adafruit/Adafruit_Crickit_PCBs/(threads)

Thread 1 (2019-11-12):

Increase 3.3v output capacity of Crickit FeatherWing

CedarGroveStudios, 2019-11-12:
If possible, suggest upgrading the 3.3V regulator on future versions to increase output capacity from 150mA to 600mA to accommodate Feather boards with NeoPixels such as the PyBadge and PyGamer. Another option would be to provide +5v to the FeatherWing USB pin to allow the attached boards to derive their own 3.3V power.
