adafruit/Adafruit_Crickit_PCBs/Adafruit Crickit FeatherWing.sch

## EAGLE design Adafruit Crickit FeatherWing.sch (2018-06-22)

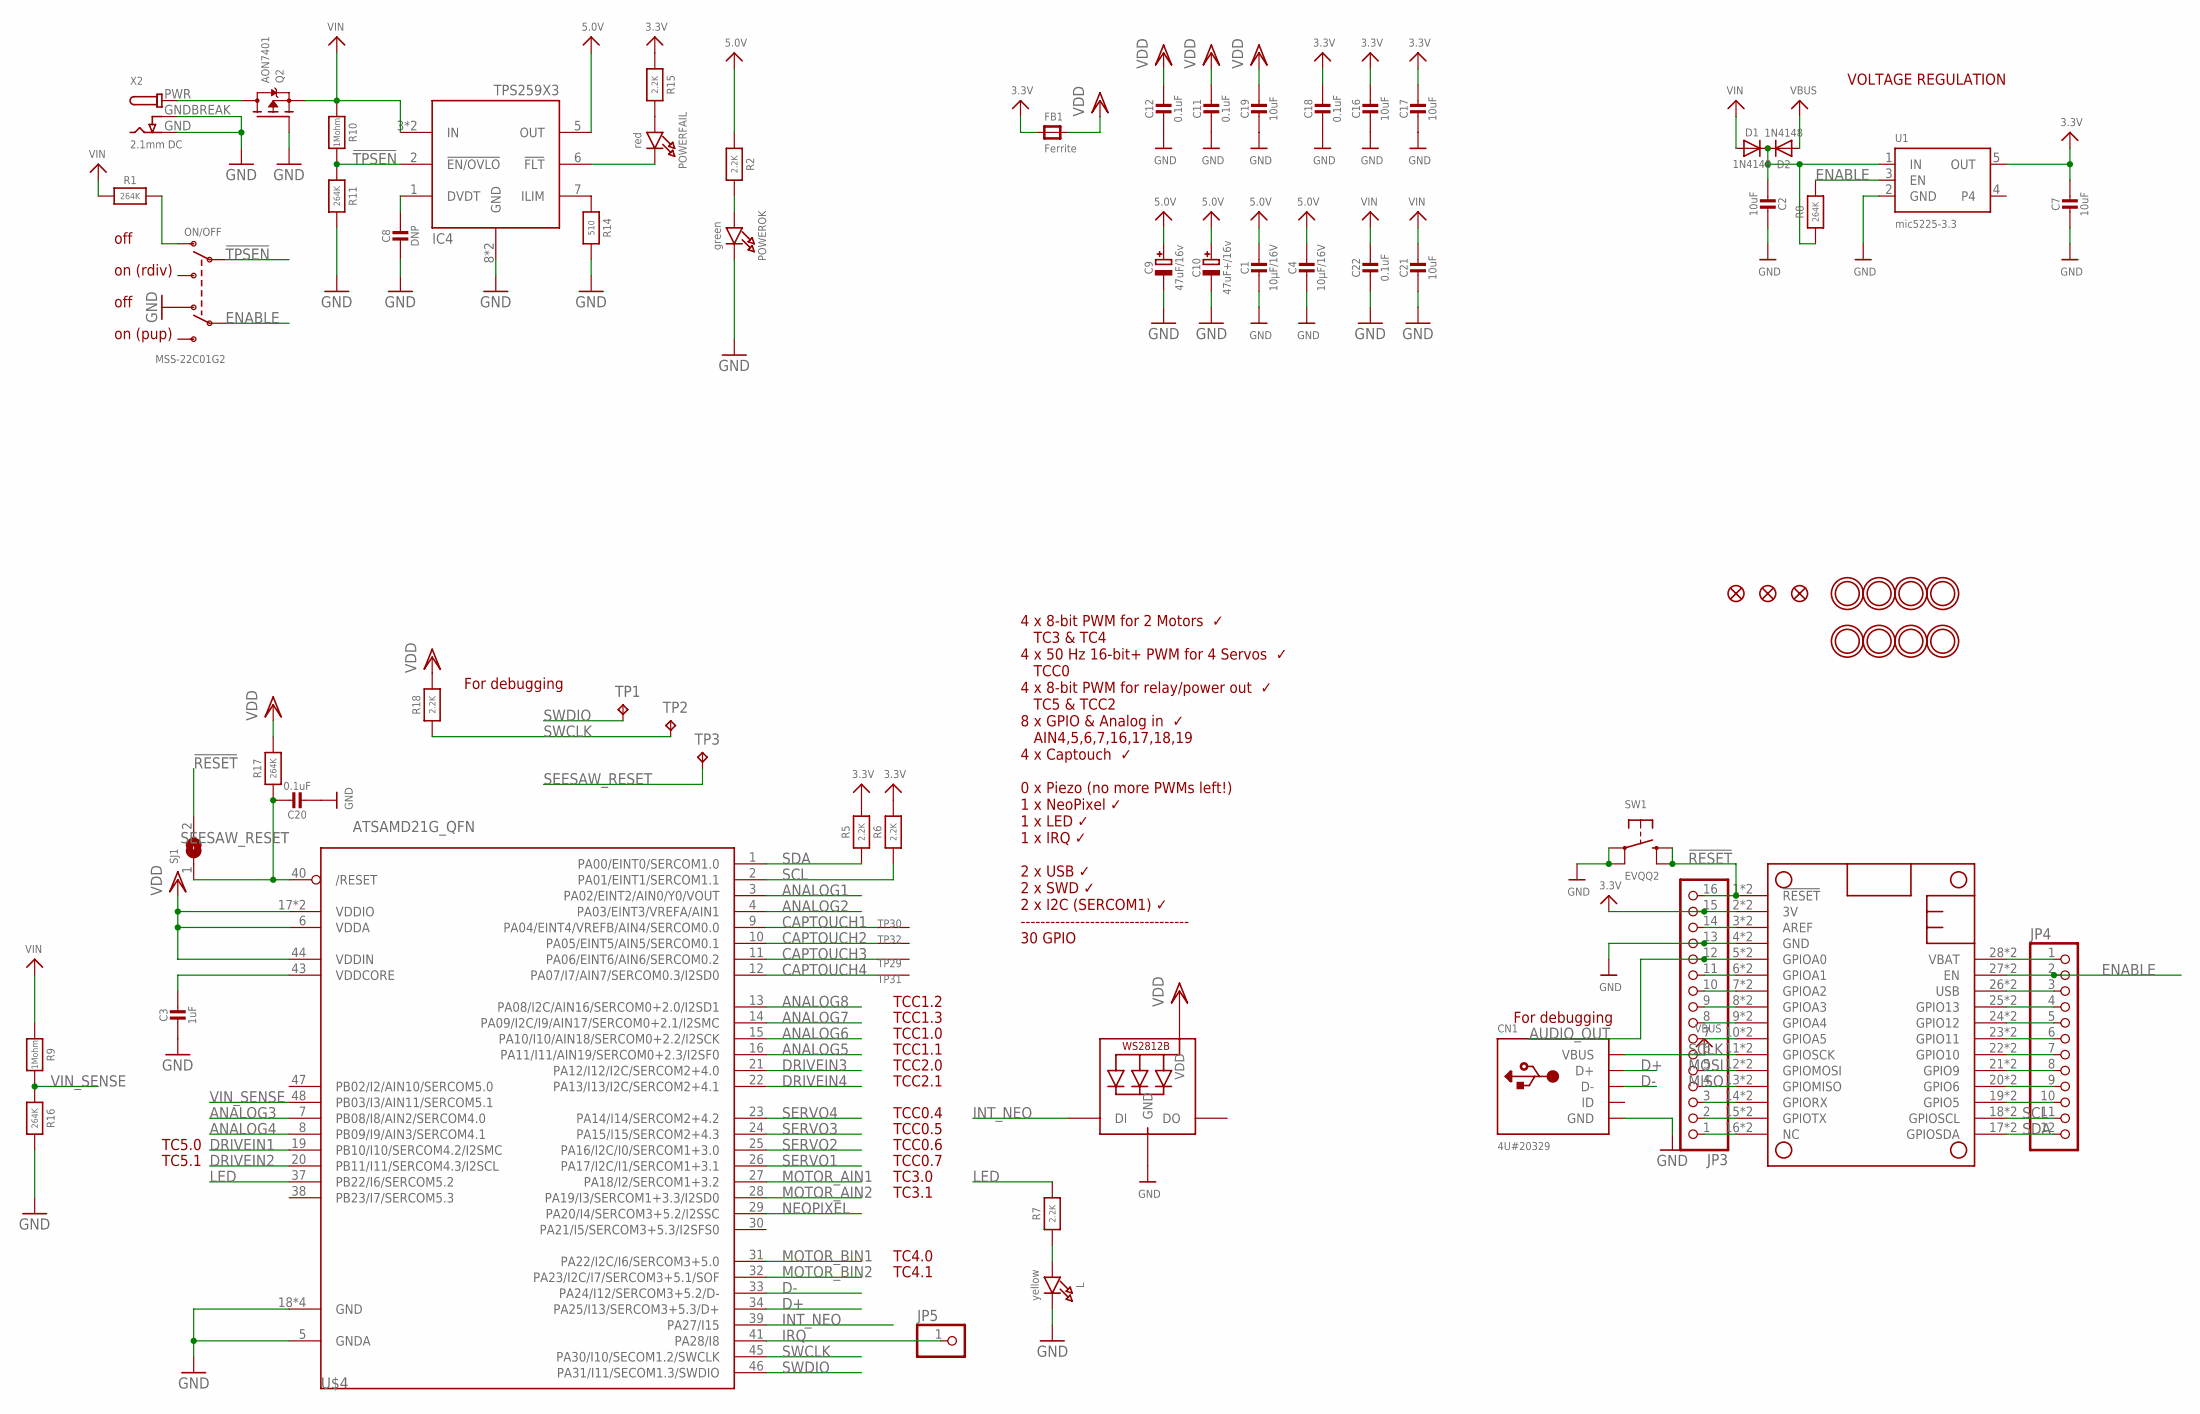
[picture p1: schematic Adafruit Crickit FeatherWing.sch, sheet 1]

Parts:
C1, C4: 10µF/16V; 0805-NO
C2, C7, C16, C17, C19, C21: 10uF; 0805-NO
C3: 1uF; 0805_10MGAP
C8: DNP; 0603-NO
C9: 47uF/16v; PANASONIC_C
C10: 47uF+/16v; PANASONIC_C
C11, C12, C18, C20, C22: 0.1uF; 0805-NO
CN1: 4U#20329; 4UCONN_20329_V2
D1, D2: 1N4148; SOD-323
FB1: Ferrite; 0805-NO
FID1, FID2, FID3: FIDUCIAL_1MM
IC4: TPS259573; WSON8
JP3: HEADER-1X16ROUND; 1X16_ROUND
JP4: HEADER-1X12; 1X12_ROUND
JP5: HEADER-1X1ROUND; 1X01_ROUND
L: yellow; CHIPLED_0805_NOOUTLINE
LED1: WS2812B3535; LED3535
MS2: FEATHERWING_SMTDUAL; FEATHERWING_SMT2
ON/OFF: MSS-22C01G2; EG1390
POWERFAIL: red; CHIPLED_0805_NOOUTLINE
POWEROK: green; CHIPLED_0805_NOOUTLINE
Q2: AON7401; POWERDI3333
R1, R8, R11, R16, R17: 264K; 0603-NO
R2, R5, R6, R7, R15, R18: 2.2K; 0603-NO
R9, R10: 1Mohm; 0603-NO
R14: 510; 0603-NO
SJ1: SOLDERJUMPERCLOSED; SOLDERJUMPER_CLOSEDWIRE
SW1: EVQQ2; EVQ-Q2_SMALLER
TP1, TP2, TP3: TPTP15R; TP15R
TP29, TP30, TP31, TP32: SEWTAPPCB_ALLIGATOR; PCB_ALLI
U1: mic5225-3.3; SOT23-5
U$4: ATSAMD21G_QFN; TQFN48_7MM
U$41, U$42, U$43, U$44, U$49, U$50, U$51, U$52: MOUNTINGHOLE3.0_NPH; MOUNTINGHOLE_3.0_NPH
X2: 2.1mm DC; DCJACK_2MM_PTH

Connections:
3.3V: C7.1, C16.1, C17.1, C18.1, FB1.1, JP3.15, MS2.2 (3V), R5.2, R6.2, R15.1, U1.5 (OUT)
5.0V: C1.1, C4.1, C9.+, C10.+, IC4.5 (OUT), R2.1
!RESET: JP3.16, MS2.1 (!RESET), SJ1.2, SW1.B (S), SW1.B' (S1)
!TPSEN: IC4.2 (!EN/OVLO), ON/OFF.P1, R10.2, R11.1
ANALOG1: U$4.3 (PA02/EINT2/AIN0/Y0/VOUT)
ANALOG2: U$4.4 (PA03/EINT3/VREFA/AIN1)
ANALOG3: U$4.7 (PB08/I8/AIN2/SERCOM4.0)
ANALOG4: U$4.8 (PB09/I9/AIN3/SERCOM4.1)
ANALOG5: U$4.16 (PA11/I11/AIN19/SERCOM0+2.3/I2SF0)
ANALOG6: U$4.15 (PA10/I10/AIN18/SERCOM0+2.2/I2SCK)
ANALOG7: U$4.14 (PA09/I2C/I9/AIN17/SERCOM0+2.1/I2SMC)
ANALOG8: U$4.13 (PA08/I2C/AIN16/SERCOM0+2.0/I2SD1)
AREF: JP3.14, MS2.3 (AREF)
AUDIO_OUT: JP3.12, MS2.5 (GPIOA0)
B: JP3.11, MS2.6 (GPIOA1)
C: JP3.10, MS2.7 (GPIOA2)
CAPTOUCH1: TP30.P$1, U$4.9 (PA04/EINT4/VREFB/AIN4/SERCOM0.0)
CAPTOUCH2: TP32.P$1, U$4.10 (PA05/EINT5/AIN5/SERCOM0.1)
CAPTOUCH3: TP29.P$1, U$4.11 (PA06/EINT6/AIN6/SERCOM0.2)
CAPTOUCH4: TP31.P$1, U$4.12 (PA07/I7/AIN7/SERCOM0.3/I2SD0)
D: JP3.9, MS2.8 (GPIOA3)
D+: CN1.D+, U$4.34 (PA25/I13/SERCOM3+5.3/D+)
D-: CN1.D-, U$4.33 (PA24/I12/SERCOM3+5.2/D-)
DRIVEIN1: U$4.19 (PB10/I10/SERCOM4.2/I2SMC)
DRIVEIN2: U$4.20 (PB11/I11/SERCOM4.3/I2SCL)
DRIVEIN3: U$4.21 (PA12/I12/I2C/SERCOM2+4.0)
DRIVEIN4: U$4.22 (PA13/I13/I2C/SERCOM2+4.1)
E: JP3.8, MS2.9 (GPIOA4)
ENABLE: JP4.2, MS2.27 (EN), ON/OFF.P2, R8.2, U1.3 (EN)
F: JP3.7, MS2.10 (GPIOA5)
G: JP3.1, MS2.16 (NC)
GND: C1.2, C2.1, C3.2, C4.2, C7.2, C8.2, C9.-, C10.-, C11.2, C12.2, C16.2, C17.2, C18.2, C19.2, C20.2, C21.2, C22.2, CN1.BASE@1 (GND), IC4.8 (GND), JP3.13, L.C, LED1.4 (GND), MS2.4 (GND), ON/OFF.O2, POWEROK.C, Q2.4 (G), R11.2, R14.2, R16.2, SW1.A, SW1.A' (P1), U1.2 (GND), U$4.5 (GNDA), U$4.18 (GND), X2.GND, X2.GNDBREAK
INT_NEO: LED1.1 (DI), U$4.39 (PA27/I15)
IRQ: JP5.1, U$4.41 (PA28/I8)
L: JP4.6, MS2.23 (GPIO11)
LED: R7.2, U$4.37 (PB22/I6/SERCOM5.2)
M: JP4.5, MS2.24 (GPIO12)
MISO: JP3.4, MS2.13 (GPIOMISO)
MOSI: JP3.5, MS2.12 (GPIOMOSI)
MOTOR_AIN1: U$4.27 (PA18/I2/SERCOM1+3.2)
MOTOR_AIN2: U$4.28 (PA19/I3/SERCOM1+3.3/I2SD0)
MOTOR_BIN1: U$4.31 (PA22/I2C/I6/SERCOM3+5.0)
MOTOR_BIN2: U$4.32 (PA23/I2C/I7/SERCOM3+5.1/SOF)
N: JP4.4, MS2.25 (GPIO13)
unnamed: C2.2, D1.C, D2.C, R8.1, U1.1 (IN)
unnamed: ON/OFF.O1, R1.2
unnamed: L.A, R7.1
unnamed: JP4.7, MS2.22 (GPIO10)
unnamed: JP4.8, MS2.21 (GPIO9)
unnamed: IC4.7 (ILIM), R14.1
unnamed: JP4.9, MS2.20 (GPIO6)
unnamed: JP4.10, MS2.19 (GPIO5)
unnamed: POWERFAIL.A, R15.2
unnamed: IC4.6 (!FLT), POWERFAIL.C
unnamed: C8.1, IC4.1 (DVDT)
unnamed: POWEROK.A, R2.2
NEOPIXEL: U$4.29 (PA20/I4/SERCOM3+5.2/I2SSC)
PWR: Q2.5678 (D), X2.PWR
RX: JP3.3, MS2.14 (GPIORX)
SCL: JP4.11, MS2.18 (GPIOSCL), R6.1, U$4.2 (PA01/EINT1/SERCOM1.1)
SCLK: JP3.6, MS2.11 (GPIOSCK)
SDA: JP4.12, MS2.17 (GPIOSDA), R5.1, U$4.1 (PA00/EINT0/SERCOM1.0)
SEESAW_RESET: C20.1, R17.1, SJ1.1, TP3.TP, U$4.40 (/RESET)
SERVO1: U$4.26 (PA17/I2C/I1/SERCOM1+3.1)
SERVO2: U$4.25 (PA16/I2C/I0/SERCOM1+3.0)
SERVO3: U$4.24 (PA15/I15/SERCOM2+4.3)
SERVO4: U$4.23 (PA14/I14/SERCOM2+4.2)
SWCLK: R18.1, TP2.TP, U$4.45 (PA30/I10/SECOM1.2/SWCLK)
SWDIO: TP1.TP, U$4.46 (PA31/I11/SECOM1.3/SWDIO)
TX: JP3.2, MS2.15 (GPIOTX)
USB: JP4.3, MS2.26 (USB)
VBAT: JP4.1, MS2.28 (VBAT)
VBUS: CN1.VBUS, D2.A
VDD: C11.1, C12.1, C19.1, FB1.2, LED1.2 (VDD), R17.2, R18.2, U$4.6 (VDDA), U$4.17 (VDDIO), U$4.44 (VDDIN)
VDDCORE: C3.1, U$4.43 (VDDCORE)
VIN: C21.1, C22.1, D1.A, IC4.3 (IN), Q2.1 (S), R1.1, R9.1, R10.1
VIN_SENSE: R9.2, R16.1, U$4.48 (PB03/I3/AIN11/SERCOM5.1)

Notes on the sheet:
TCC2.1
TCC2.0
TCC1.2
TCC1.3
TCC1.1
TCC1.0
TCC0.4
TCC0.5
TCC0.6
TCC0.7
TC3.0
TC3.1
TC4.0
TC4.1
4 x 8-bit PWM for 2 Motors ✓ TC3 & TC4 4 x 50 Hz 16-bit+ PWM for 4 Servos ✓ TCC0 4 x 8-bit PWM for relay/power out ✓ TC5 & TCC2 8 x GPIO & Analog in ✓ AIN4,5,6,7,16,17,18,19 4 x Captouch ✓ 0 x Piezo (no more PWMs left!) 1 x NeoPixel ✓ 1 x LED ✓ 1 x IRQ ✓ 2 x USB ✓ 2 x SWD ✓ 2 x I2C (SERCOM1) ✓ ----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
TC5.0
TC5.1
For debugging
VOLTAGE REGULATION
off
on (rdiv)
on (pup)

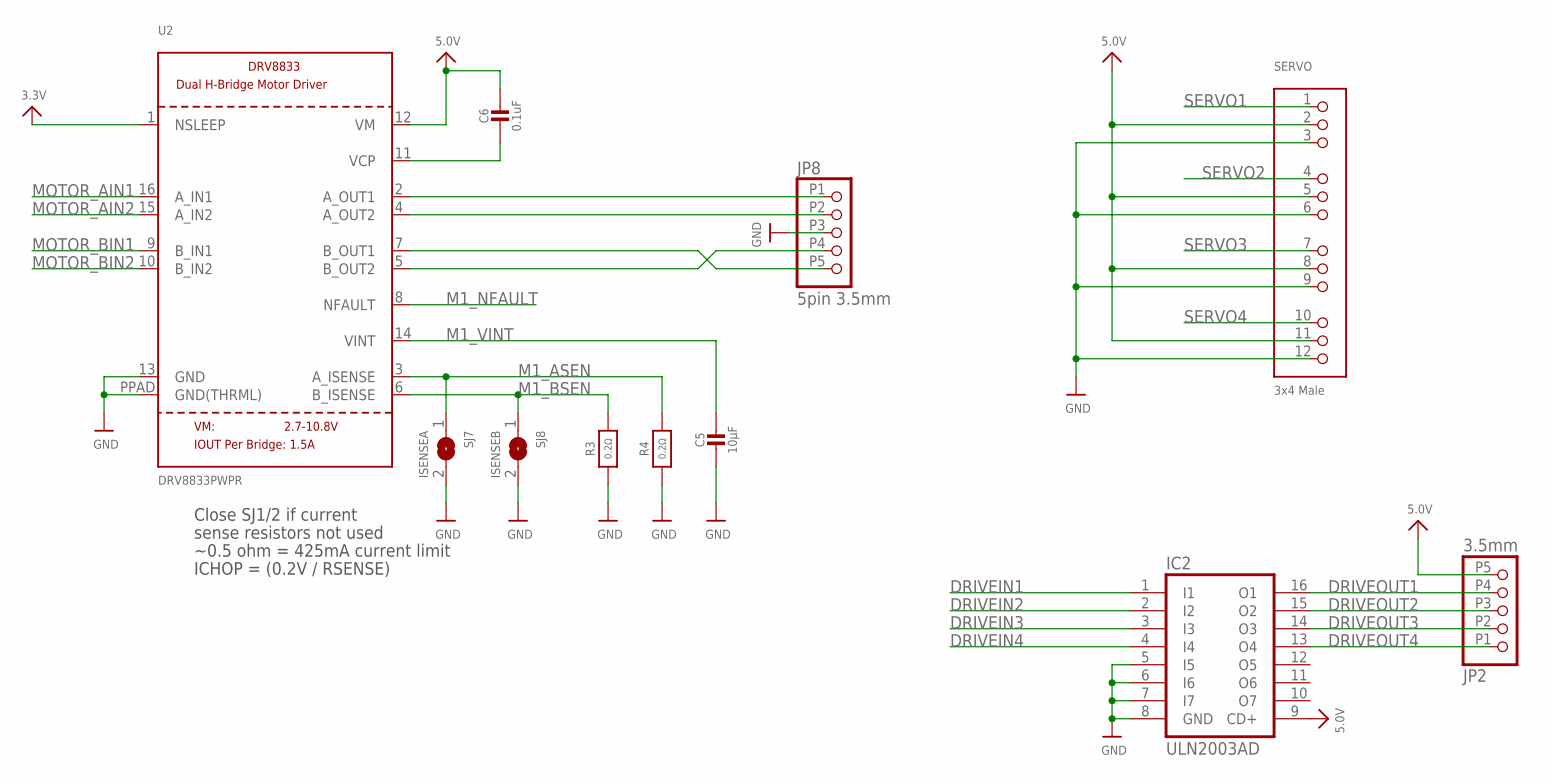
[picture p2: schematic Adafruit Crickit FeatherWing.sch, sheet 2]

Parts:
C5: 10µF; 0805-NO
C6: 0.1uF; 0805-NO
IC2: ULN2003AD; SO16
JP2: 3.5mm; TERMBLOC_1X5-3.5MM
JP8: 5pin 3.5mm; TERMBLOC_1X5-3.5MM
R3, R4: 0.2Ω; _1206
SERVO: 3x4 Male; 3X04
SJ7: ISENSEA; SOLDERJUMPER_ARROW_NOPASTE
SJ8: ISENSEB; SOLDERJUMPER_ARROW_NOPASTE
U2: DRV8833PWPR; HTSSOP16

Connections:
3.3V: U2.1 (NSLEEP)
5.0V: C6.1, IC2.9 (CD+), JP2.P5 (5), SERVO.2, SERVO.5, SERVO.8, SERVO.11, U2.12 (VM)
AOUT3: JP8.P1 (1), U2.2 (A_OUT1)
AOUT4: JP8.P2 (2), U2.4 (A_OUT2)
DRIVEIN1: IC2.1 (I1)
DRIVEIN2: IC2.2 (I2)
DRIVEIN3: IC2.3 (I3)
DRIVEIN4: IC2.4 (I4)
DRIVEOUT1: IC2.16 (O1), JP2.P4 (4)
DRIVEOUT2: IC2.15 (O2), JP2.P3 (3)
DRIVEOUT3: IC2.14 (O3), JP2.P2 (2)
DRIVEOUT4: IC2.13 (O4), JP2.P1 (1)
GND: C5.2, IC2.5 (I5), IC2.6 (I6), IC2.7 (I7), IC2.8 (GND), JP8.P3 (3), R3.1, R4.1, SERVO.3, SERVO.6, SERVO.9, SERVO.12, SJ7.2, SJ8.2, U2.13 (GND), U2.PPAD (GND(THRML))
M1_ASEN: R4.2, SJ7.1, U2.3 (A_ISENSE)
M1_BSEN: R3.2, SJ8.1, U2.6 (B_ISENSE)
M1_NFAULT: U2.8 (NFAULT)
M1_VINT: C5.1, U2.14 (VINT)
MOTOR_AIN1: U2.16 (A_IN1)
MOTOR_AIN2: U2.15 (A_IN2)
MOTOR_BIN1: U2.9 (B_IN1)
MOTOR_BIN2: U2.10 (B_IN2)
unnamed: C6.2, U2.11 (VCP)
unnamed: JP8.P5 (5), U2.7 (B_OUT1)
unnamed: JP8.P4 (4), U2.5 (B_OUT2)
SERVO1: SERVO.1
SERVO2: SERVO.4
SERVO3: SERVO.7
SERVO4: SERVO.10

Notes on the sheet:
Close SJ1/2 if current
sense resistors not used
~0.5 ohm = 425mA current limit
ICHOP = (0.2V / RSENSE)

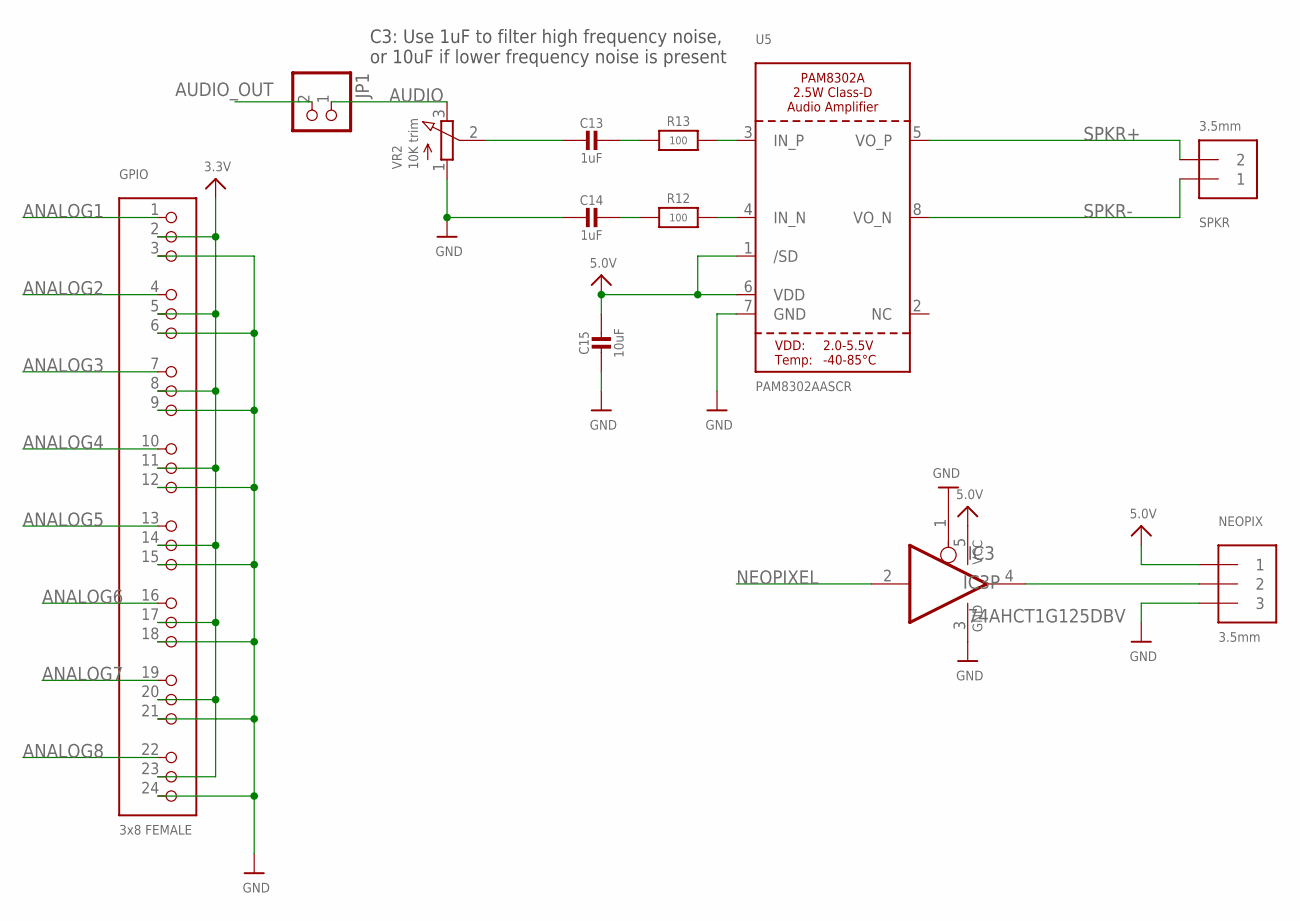
[picture p3: schematic Adafruit Crickit FeatherWing.sch, sheet 3]

Parts:
C13, C14: 1uF; 0805-NO
C15: 10uF; 0805-NO
GPIO: 3x8 FEMALE; 3X08
IC3: 74AHCT1G125DBV; SOT23-5
JP1: HEADER-1X2ROUND; 1X02_ROUND
NEOPIX: 3.5mm; TERMBLOCK_1X3-3.5MM
R12, R13: 100; 0805-NO
SPKR: 3.5mm; TERMBLOCK_1X2-3.5MM
U5: PAM8302AASCR; MSOP8_0.65MM
VR2: 10K trim; TRIMPOT_BOURNS_3303W

Connections:
3.3V: GPIO.2, GPIO.5, GPIO.8, GPIO.11, GPIO.14, GPIO.17, GPIO.20, GPIO.23
5.0V: C15.1, IC3.5 (VCC), NEOPIX.1, U5.1 (/SD), U5.6 (VDD)
ANALOG1: GPIO.1
ANALOG2: GPIO.4
ANALOG3: GPIO.7
ANALOG4: GPIO.10
ANALOG5: GPIO.13
ANALOG6: GPIO.16
ANALOG7: GPIO.19
ANALOG8: GPIO.22
AUDIO: JP1.1, VR2.3 (E)
AUDIO_OUT: JP1.2
GND: C14.2, C15.2, GPIO.3, GPIO.6, GPIO.9, GPIO.12, GPIO.15, GPIO.18, GPIO.21, GPIO.24, IC3.1 (OE), IC3.3 (GND), NEOPIX.3, U5.7 (GND), VR2.1 (A)
unnamed: IC3.4 (O), NEOPIX.2
unnamed: R12.2, U5.4 (IN_N)
unnamed: R13.2, U5.3 (IN_P)
unnamed: C14.1, R12.1
unnamed: C13.1, R13.1
unnamed: C13.2, VR2.2 (S)
NEOPIXEL: IC3.2 (I)
SPKR+: SPKR.2, U5.5 (VO_P)
SPKR-: SPKR.1, U5.8 (VO_N)

Notes on the sheet:
C3: Use 1uF to filter high frequency noise, or 10uF if lower frequency noise is present
