adafruit/Adafruit_Crickit_PCBs/Adafruit Crickit HAT.sch

## EAGLE design Adafruit Crickit HAT.sch (2018-12-14)

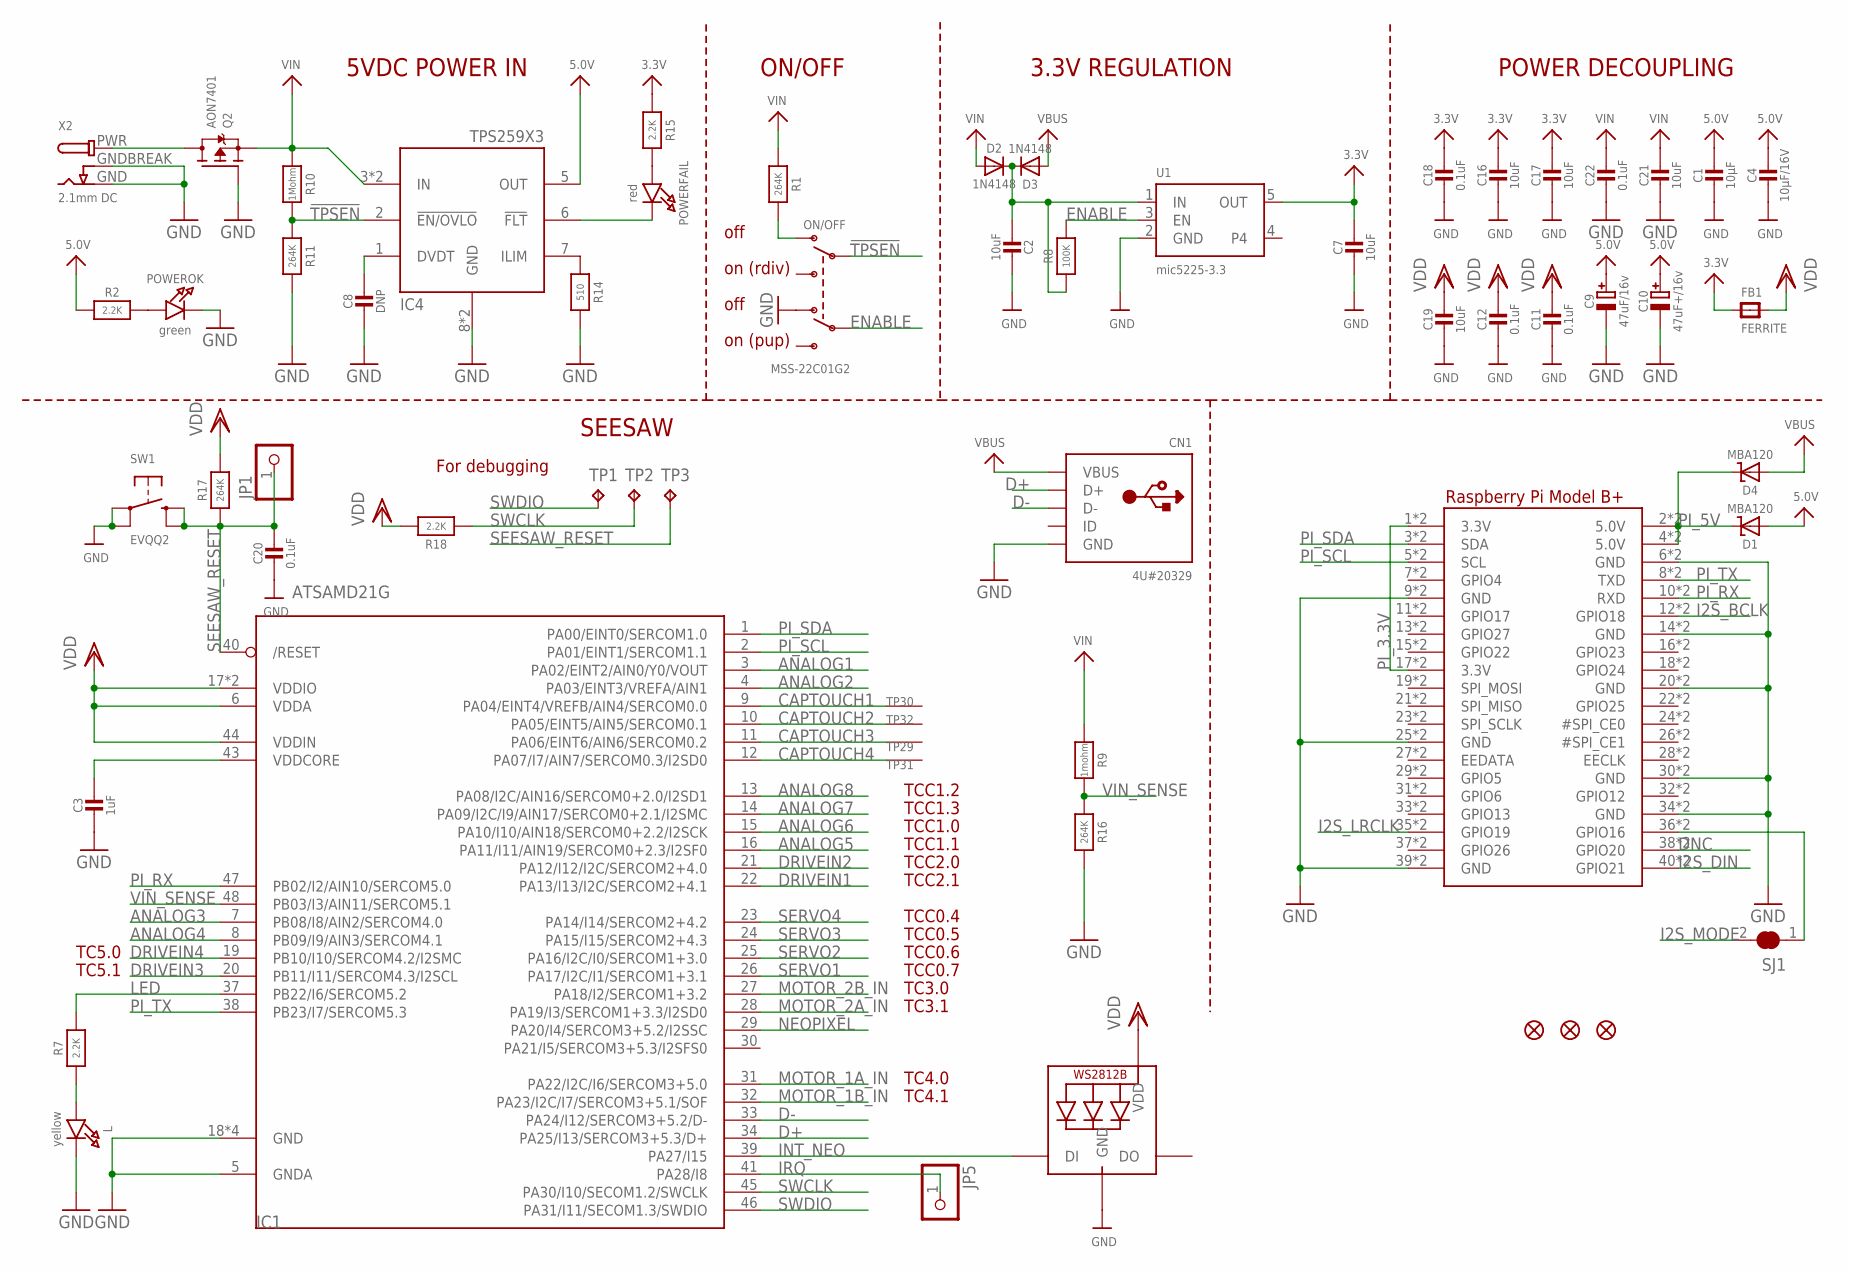
[picture p4: schematic Adafruit Crickit HAT.sch, sheet 1]

Parts:
C1: 10µF; 0805-NO
C2, C7, C16, C17, C19, C21: 10uF; 0805-NO
C3: 1uF; 0805-NO
C4: 10µF/16V; 0805-NO
C8: DNP; 0603-NO
C9: 47uF/16v; PANASONIC_C
C10: 47uF+/16v; PANASONIC_C
C11, C12, C18, C20, C22: 0.1uF; 0603-NO
CN1: 4U#20329; 4UCONN_20329_V2
D1, D4: MBA120; SOD-123
D2, D3: 1N4148; SOD-323
FB1: FERRITE; _0805MP
FID1, FID2, FID3: FIDUCIAL_1MM
IC1: ATSAMD21G; TQFN48_7MM
IC4: TPS259573; WSON8
JP1, JP5: HEADER-1X1ROUND; 1X01_ROUND
L: yellow; CHIPLED_0805_NOOUTLINE
LED1: WS2812B3535; LED3535
ON/OFF: MSS-22C01G2; EG1390
POWERFAIL: red; CHIPLED_0805_NOOUTLINE
POWEROK: green; CHIPLED_0805_NOOUTLINE
Q2: AON7401; POWERDI3333
R1, R11, R16, R17: 264K; 0603-NO
R2, R7, R15, R18: 2.2K; 0603-NO
R8: 100K; 0603-NO
R9: 1mohm; 0603-NO
R10: 1Mohm; 0603-NO
R14: 510; 0603-NO
RPI1: RASPBERRYPI_BPLUS_HAT_SMTTHM_SLOTS; PI_HAT_SMTTHM_SLOTS
SJ1: SOLDERJUMPER_CLOSED; SOLDERJUMPER_CLOSEDWIRE
SW1: EVQQ2; BTN_KMR2_4.6X2.8
TP1, TP2, TP3: TPTP15R; TP15R
TP29, TP30, TP31, TP32: SEWTAPPCB_ALLIGATOR; PCB_ALLI
U1: mic5225-3.3; SOT23-5
X2: 2.1mm DC; DCJACK_2MM_PTH

Connections:
3.3V: C7.1, C16.1, C17.1, C18.1, FB1.1, R15.1, U1.5 (OUT)
5.0V: C1.1, C4.1, C9.+, C10.+, D1.A, IC4.5 (OUT), R2.1
!TPSEN: IC4.2 (!EN/OVLO), ON/OFF.P1, R10.2, R11.1
ANALOG1: IC1.3 (PA02/EINT2/AIN0/Y0/VOUT)
ANALOG2: IC1.4 (PA03/EINT3/VREFA/AIN1)
ANALOG3: IC1.7 (PB08/I8/AIN2/SERCOM4.0)
ANALOG4: IC1.8 (PB09/I9/AIN3/SERCOM4.1)
ANALOG5: IC1.16 (PA11/I11/AIN19/SERCOM0+2.3/I2SF0)
ANALOG6: IC1.15 (PA10/I10/AIN18/SERCOM0+2.2/I2SCK)
ANALOG7: IC1.14 (PA09/I2C/I9/AIN17/SERCOM0+2.1/I2SMC)
ANALOG8: IC1.13 (PA08/I2C/AIN16/SERCOM0+2.0/I2SD1)
CAPTOUCH1: IC1.9 (PA04/EINT4/VREFB/AIN4/SERCOM0.0), TP30.P$1
CAPTOUCH2: IC1.10 (PA05/EINT5/AIN5/SERCOM0.1), TP32.P$1
CAPTOUCH3: IC1.11 (PA06/EINT6/AIN6/SERCOM0.2), TP29.P$1
CAPTOUCH4: IC1.12 (PA07/I7/AIN7/SERCOM0.3/I2SD0), TP31.P$1
D+: CN1.D+, IC1.34 (PA25/I13/SERCOM3+5.3/D+)
D-: CN1.D-, IC1.33 (PA24/I12/SERCOM3+5.2/D-)
DNC: RPI1.38 (GPIO20)
DRIVEIN1: IC1.22 (PA13/I13/I2C/SERCOM2+4.1)
DRIVEIN2: IC1.21 (PA12/I12/I2C/SERCOM2+4.0)
DRIVEIN3: IC1.20 (PB11/I11/SERCOM4.3/I2SCL)
DRIVEIN4: IC1.19 (PB10/I10/SERCOM4.2/I2SMC)
ENABLE: ON/OFF.P2, R8.2, U1.3 (EN)
GND: C1.2, C2.1, C3.2, C4.2, C7.2, C8.2, C9.-, C10.-, C11.2, C12.2, C16.2, C17.2, C18.2, C19.2, C20.2, C21.2, C22.2, CN1.BASE@1 (GND), IC1.5 (GNDA), IC1.18 (GND), IC4.8 (GND), L.C, LED1.4 (GND), ON/OFF.O2, POWEROK.C, Q2.4 (G), R11.2, R14.2, R16.2, RPI1.6 (GND), RPI1.9 (GND), RPI1.14 (GND), RPI1.20 (GND), RPI1.25 (GND), RPI1.30 (GND), RPI1.34 (GND), RPI1.39 (GND), SW1.A, SW1.A' (P1), U1.2 (GND), X2.GND, X2.GNDBREAK
I2S_BCLK: RPI1.12 (GPIO18)
I2S_DIN: RPI1.40 (GPIO21)
I2S_LRCLK: RPI1.35 (GPIO19)
I2S_MODE: SJ1.2
INT_NEO: IC1.39 (PA27/I15), LED1.1 (DI)
IRQ: IC1.41 (PA28/I8), JP5.1
LED: IC1.37 (PB22/I6/SERCOM5.2), R7.2
MOTOR_1A_IN: IC1.31 (PA22/I2C/I6/SERCOM3+5.0)
MOTOR_1B_IN: IC1.32 (PA23/I2C/I7/SERCOM3+5.1/SOF)
MOTOR_2A_IN: IC1.28 (PA19/I3/SERCOM1+3.3/I2SD0)
MOTOR_2B_IN: IC1.27 (PA18/I2/SERCOM1+3.2)
unnamed: RPI1.36 (GPIO16), SJ1.1
unnamed: ON/OFF.O1, R1.2
unnamed: L.A, R7.1
unnamed: IC4.7 (ILIM), R14.1
unnamed: POWERFAIL.A, R15.2
unnamed: IC4.6 (!FLT), POWERFAIL.C
unnamed: C8.1, IC4.1 (DVDT)
unnamed: POWEROK.A, R2.2
NEOPIXEL: IC1.29 (PA20/I4/SERCOM3+5.2/I2SSC)
PI_3.3V: RPI1.1 (3.3V), RPI1.17 (3.3V)
PI_5V: D1.C, D4.C, RPI1.2 (5.0V), RPI1.4 (5.0V)
PI_RX: IC1.47 (PB02/I2/AIN10/SERCOM5.0), RPI1.10 (RXD)
PI_SCL: IC1.2 (PA01/EINT1/SERCOM1.1), RPI1.5 (SCL)
PI_SDA: IC1.1 (PA00/EINT0/SERCOM1.0), RPI1.3 (SDA)
PI_TX: IC1.38 (PB23/I7/SERCOM5.3), RPI1.8 (TXD)
PWR: Q2.5678 (D), X2.PWR
SEESAW_RESET: C20.1, IC1.40 (/RESET), JP1.1, R17.1, SW1.B (S), SW1.B' (S1), TP3.TP
SERVO1: IC1.26 (PA17/I2C/I1/SERCOM1+3.1)
SERVO2: IC1.25 (PA16/I2C/I0/SERCOM1+3.0)
SERVO3: IC1.24 (PA15/I15/SERCOM2+4.3)
SERVO4: IC1.23 (PA14/I14/SERCOM2+4.2)
SWCLK: IC1.45 (PA30/I10/SECOM1.2/SWCLK), R18.1, TP2.TP
SWDIO: IC1.46 (PA31/I11/SECOM1.3/SWDIO), TP1.TP
VBUS: CN1.VBUS, D3.A, D4.A
VDD: C11.1, C12.1, C19.1, FB1.2, IC1.6 (VDDA), IC1.17 (VDDIO), IC1.44 (VDDIN), LED1.2 (VDD), R17.2, R18.2
VDDCORE: C3.1, IC1.43 (VDDCORE)
VHI: C2.2, D2.C, D3.C, R8.1, U1.1 (IN)
VIN: C21.1, C22.1, D2.A, IC4.3 (IN), Q2.1 (S), R1.1, R9.1, R10.1
VIN_SENSE: IC1.48 (PB03/I3/AIN11/SERCOM5.1), R9.2, R16.1

Notes on the sheet:
TCC2.1
TCC2.0
TCC1.2
TCC1.3
TCC1.1
TCC1.0
TCC0.4
TCC0.5
TCC0.6
TCC0.7
TC3.0
TC3.1
TC4.0
TC4.1
TC5.0
TC5.1
3.3V REGULATION
off
on (rdiv)
on (pup)
For debugging
ON/OFF
5VDC POWER IN
POWER DECOUPLING
SEESAW

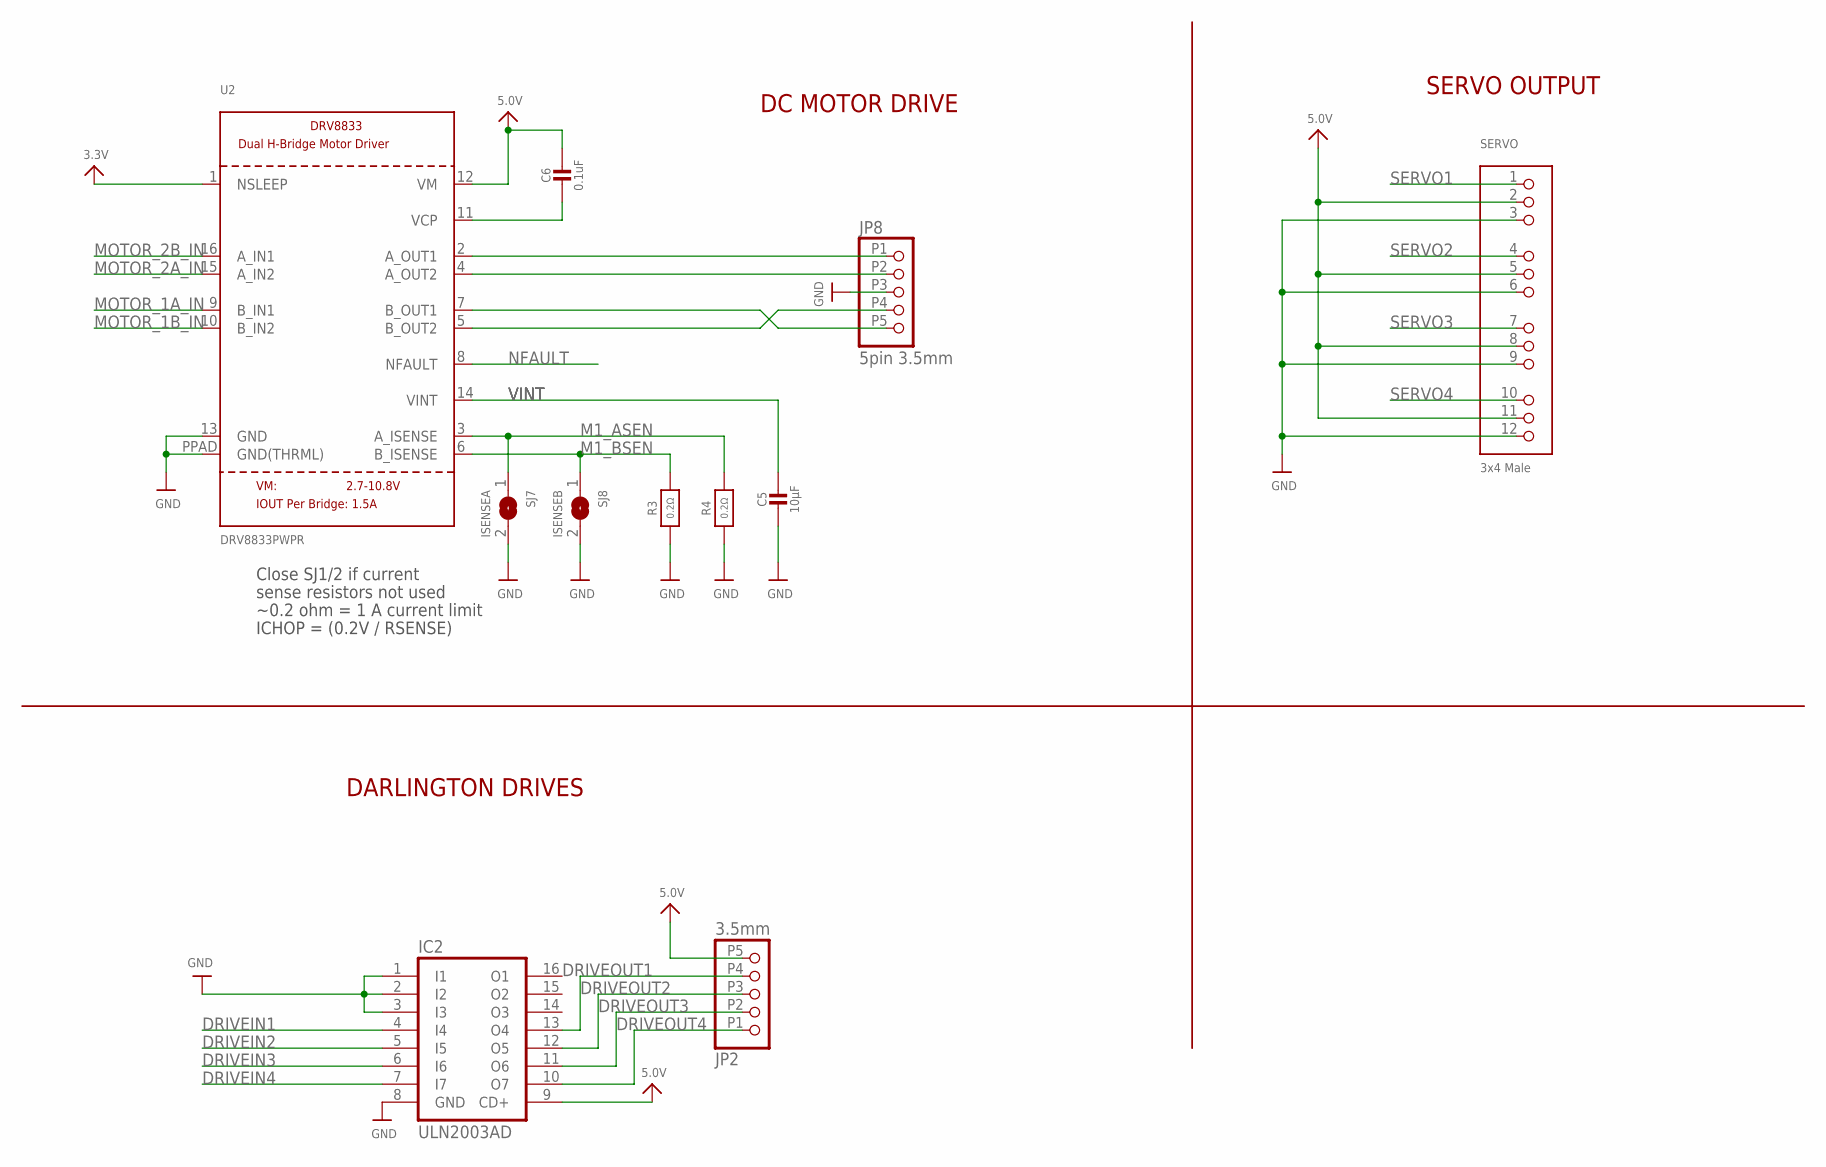
[picture p5: schematic Adafruit Crickit HAT.sch, sheet 2]

Parts:
C5: 10µF; 0805-NO
C6: 0.1uF; 0603-NO
IC2: ULN2003AD; SO16
JP2: 3.5mm; TERMBLOCK_1X5-3.5MM
JP8: 5pin 3.5mm; TERMBLOCK_1X5-3.5MM
R3, R4: 0.2Ω; _1206
SERVO: 3x4 Male; 3X04
SJ7: ISENSEA; SOLDERJUMPER_ARROW_NOPASTE
SJ8: ISENSEB; SOLDERJUMPER_ARROW_NOPASTE
U2: DRV8833PWPR; HTSSOP16

Connections:
3.3V: U2.1 (NSLEEP)
5.0V: C6.1, IC2.9 (CD+), JP2.P5 (5), SERVO.2, SERVO.5, SERVO.8, SERVO.11, U2.12 (VM)
DRIVEIN1: IC2.4 (I4)
DRIVEIN2: IC2.5 (I5)
DRIVEIN3: IC2.6 (I6)
DRIVEIN4: IC2.7 (I7)
DRIVEOUT1: IC2.13 (O4), JP2.P4 (4)
DRIVEOUT2: IC2.12 (O5), JP2.P3 (3)
DRIVEOUT3: IC2.11 (O6), JP2.P2 (2)
DRIVEOUT4: IC2.10 (O7), JP2.P1 (1)
GND: C5.2, IC2.1 (I1), IC2.2 (I2), IC2.3 (I3), IC2.8 (GND), JP8.P3 (3), R3.1, R4.1, SERVO.3, SERVO.6, SERVO.9, SERVO.12, SJ7.2, SJ8.2, U2.13 (GND), U2.PPAD (GND(THRML))
M1_ASEN: R4.2, SJ7.1, U2.3 (A_ISENSE)
M1_BSEN: R3.2, SJ8.1, U2.6 (B_ISENSE)
MOTOR_1A_IN: U2.9 (B_IN1)
MOTOR_1A_OUT: JP8.P5 (5), U2.7 (B_OUT1)
MOTOR_1B_IN: U2.10 (B_IN2)
MOTOR_1B_OUT: JP8.P4 (4), U2.5 (B_OUT2)
MOTOR_2A_IN: U2.15 (A_IN2)
MOTOR_2A_OUT: JP8.P2 (2), U2.4 (A_OUT2)
MOTOR_2B_IN: U2.16 (A_IN1)
MOTOR_2B_OUT: JP8.P1 (1), U2.2 (A_OUT1)
unnamed: C6.2, U2.11 (VCP)
NFAULT: U2.8 (NFAULT)
SERVO1: SERVO.1
SERVO2: SERVO.4
SERVO3: SERVO.7
SERVO4: SERVO.10
VINT: C5.1, U2.14 (VINT)

Notes on the sheet:
Close SJ1/2 if current
sense resistors not used
~0.2 ohm = 1 A current limit
ICHOP = (0.2V / RSENSE)
DC MOTOR DRIVE
SERVO OUTPUT
DARLINGTON DRIVES

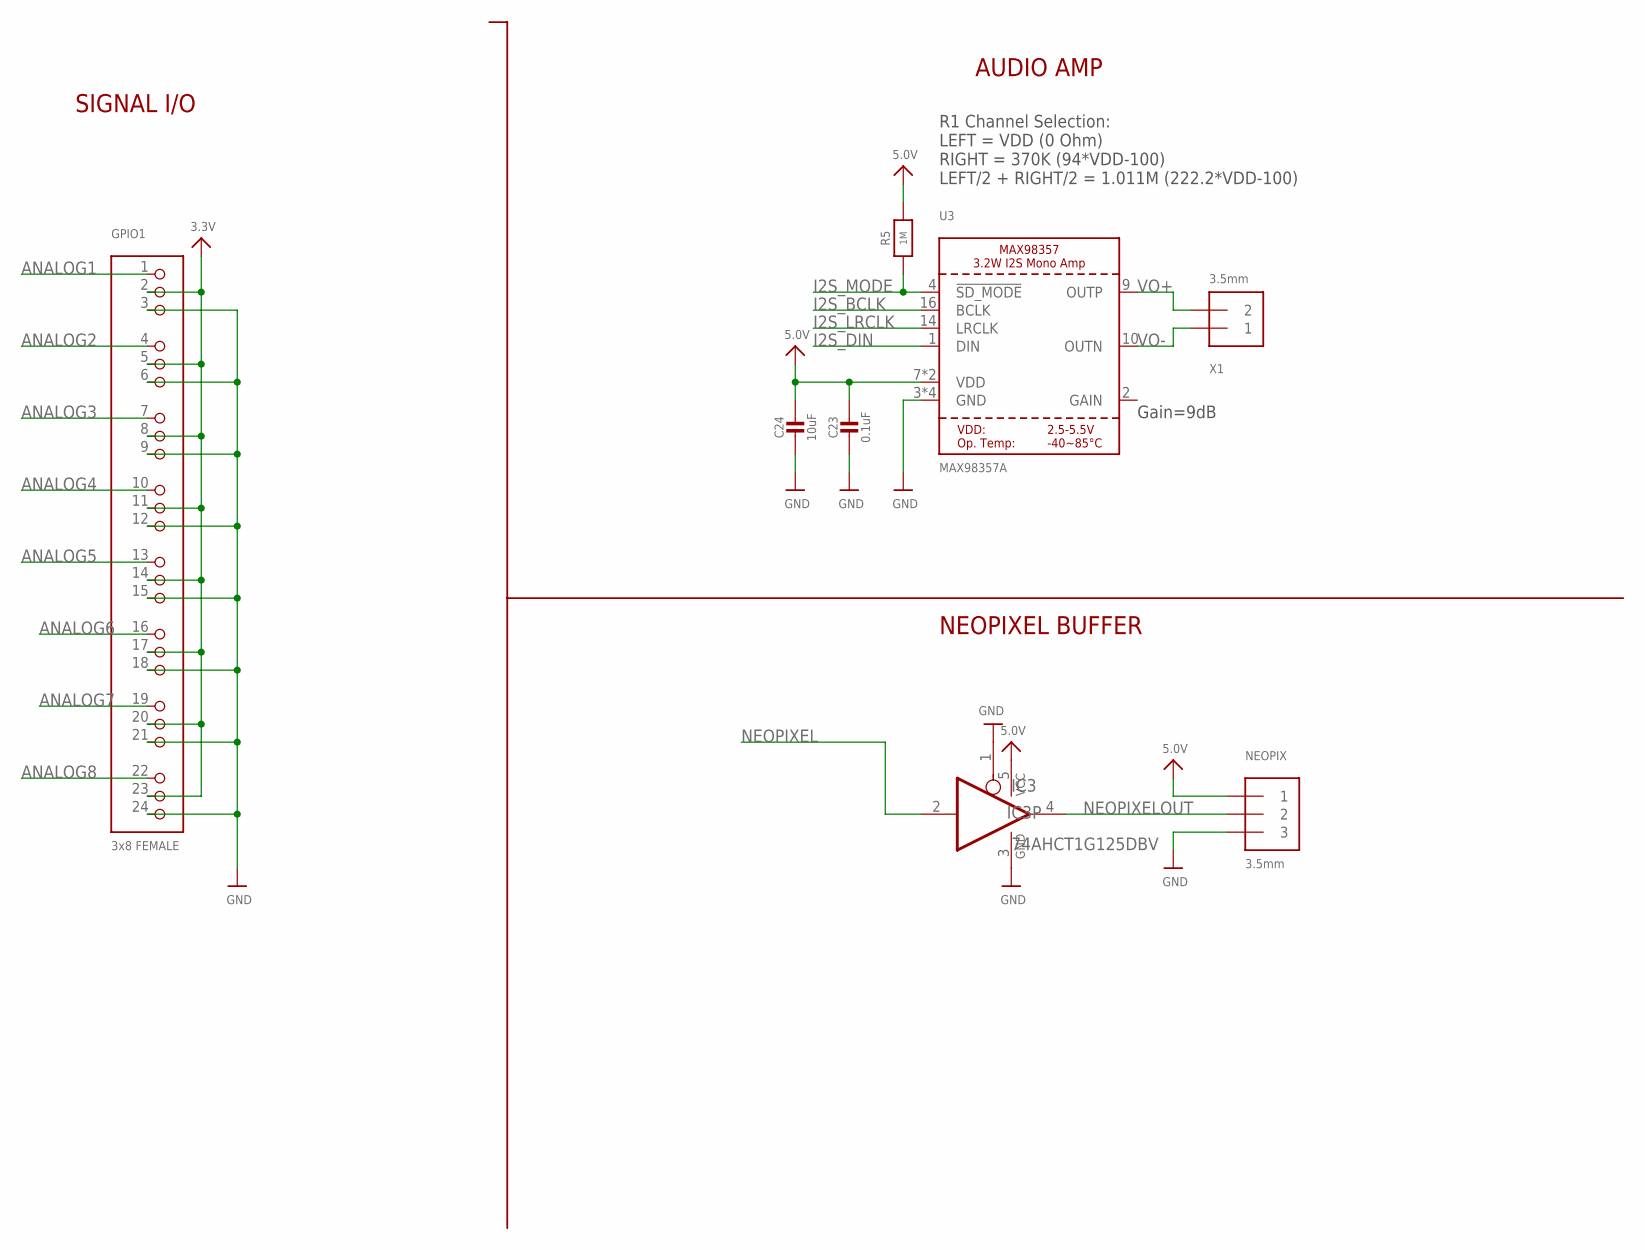
[picture p6: schematic Adafruit Crickit HAT.sch, sheet 3]

Parts:
C23: 0.1uF; 0603-NO
C24: 10uF; 0805-NO
GPIO1: 3x8 FEMALE; 3X08
IC3: 74AHCT1G125DBV; SOT23-5
NEOPIX: 3.5mm; TERMBLOCK_1X3-3.5MM
R5: 1M; 0603-NO
U3: MAX98357A; QFN16_3MM
X1: 3.5mm; TERMBLOCK_1X2-3.5MM

Connections:
3.3V: GPIO1.2, GPIO1.5, GPIO1.8, GPIO1.11, GPIO1.14, GPIO1.17, GPIO1.20, GPIO1.23
5.0V: C23.1, C24.1, IC3.5 (VCC), NEOPIX.1, R5.2, U3.7 (VDD)
ANALOG1: GPIO1.1
ANALOG2: GPIO1.4
ANALOG3: GPIO1.7
ANALOG4: GPIO1.10
ANALOG5: GPIO1.13
ANALOG6: GPIO1.16
ANALOG7: GPIO1.19
ANALOG8: GPIO1.22
GND: C23.2, C24.2, GPIO1.3, GPIO1.6, GPIO1.9, GPIO1.12, GPIO1.15, GPIO1.18, GPIO1.21, GPIO1.24, IC3.1 (OE), IC3.3 (GND), NEOPIX.3, U3.3 (GND)
I2S_BCLK: U3.16 (BCLK)
I2S_DIN: U3.1 (DIN)
I2S_LRCLK: U3.14 (LRCLK)
I2S_MODE: R5.1, U3.4 (!SD_MODE)
NEOPIXEL: IC3.2 (I)
NEOPIXELOUT: IC3.4 (O), NEOPIX.2
VO+: U3.9 (OUTP), X1.2
VO-: U3.10 (OUTN), X1.1

Notes on the sheet:
SIGNAL I/O
AUDIO AMP
NEOPIXEL BUFFER
R1 Channel Selection: LEFT = VDD (0 Ohm) RIGHT = 370K (94*VDD-100) LEFT/2 + RIGHT/2 = 1.011M (222.2*VDD-100)
Gain=9dB
