adafruit/Adafruit_Crickit_PCBs/(commit log)

2018-06-22 feather ver
    [Adafruit Crickit FeatherWing.sch]
2018-11-02 lil bit crikit bit
    [Adafruit Crickit for microbit.sch]
2018-12-14 le HAT
    [Adafruit Crickit HAT.sch]
